StormTrooper/Commodore-Plus4/3d/pushbutton-switch.step

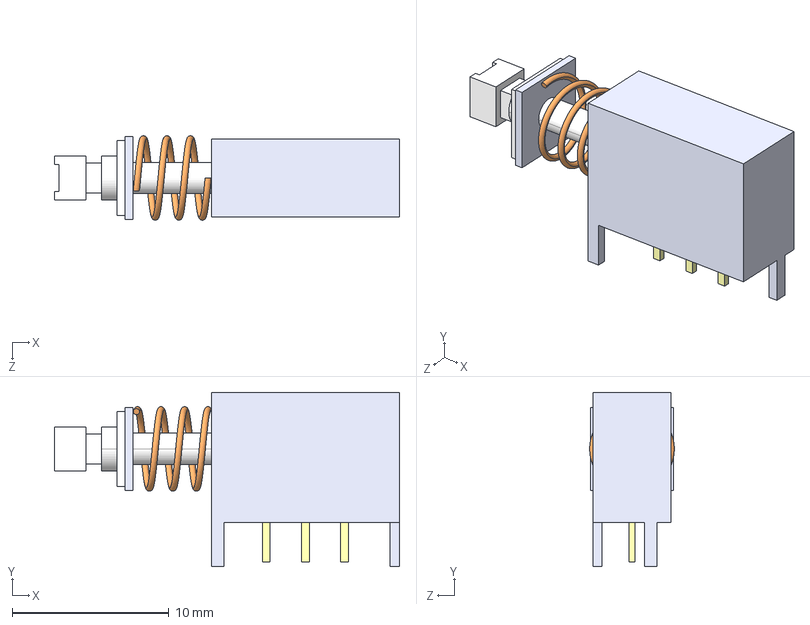
[picture p2: CAD file, 2019-05-24]
3d/pushbutton-switch.step
22.0 x 11.1 x 5.40 mm
