StormTrooper/Commodore-Plus4/3d/rectifier.step

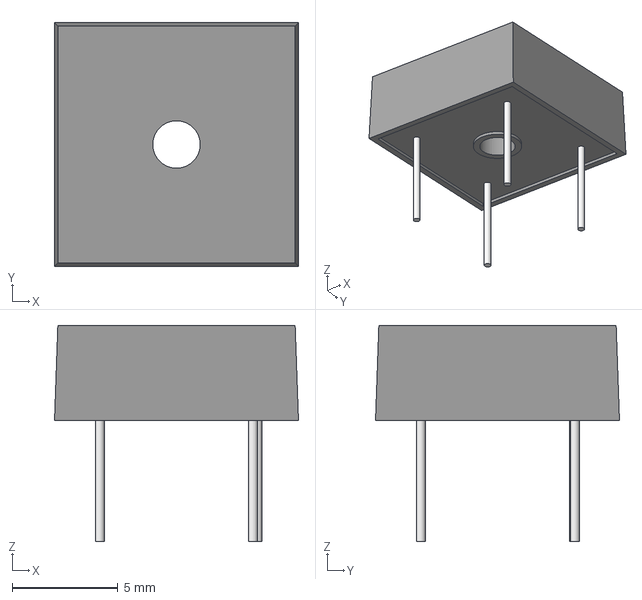
[picture p3: CAD file, 2019-05-24]
3d/rectifier.step
11.5 x 11.5 x 10.2 mm
