StormTrooper/Commodore-Plus4/Commodore Plus 4.kicad_pcb

## KiCad design Commodore Plus 4.kicad_pcb (2019-05-24)

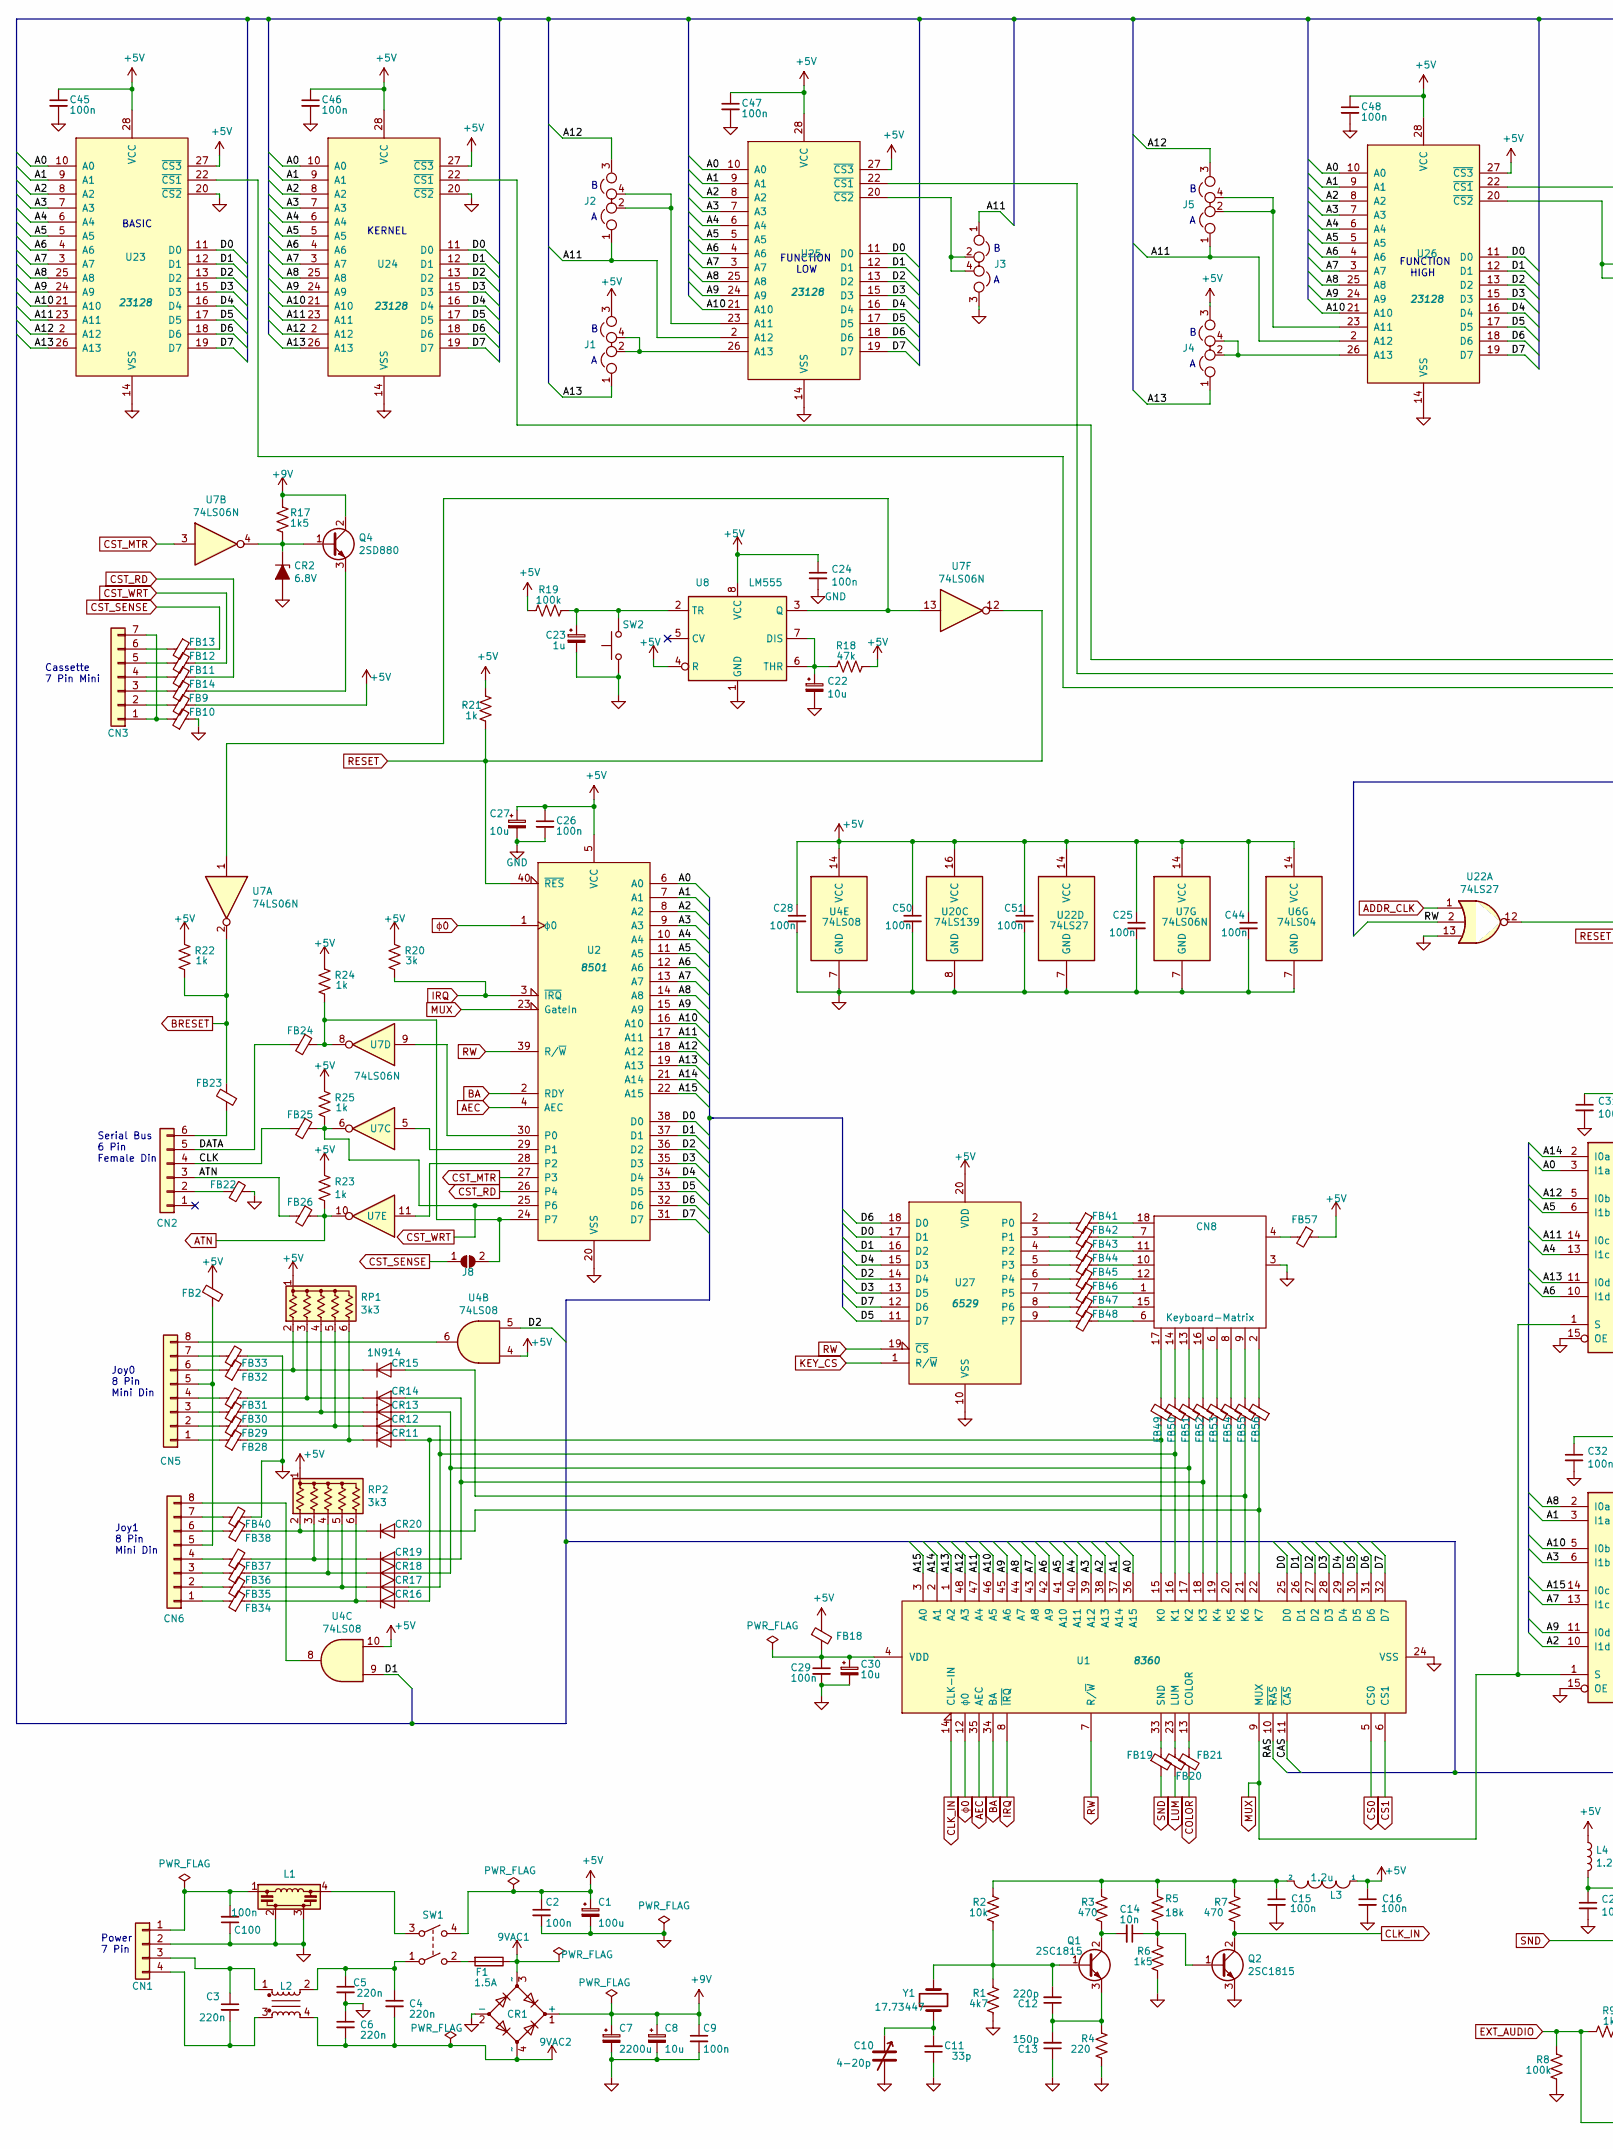
[picture p4: schematic Commodore Plus 4.sch, part in row 1, column 1]

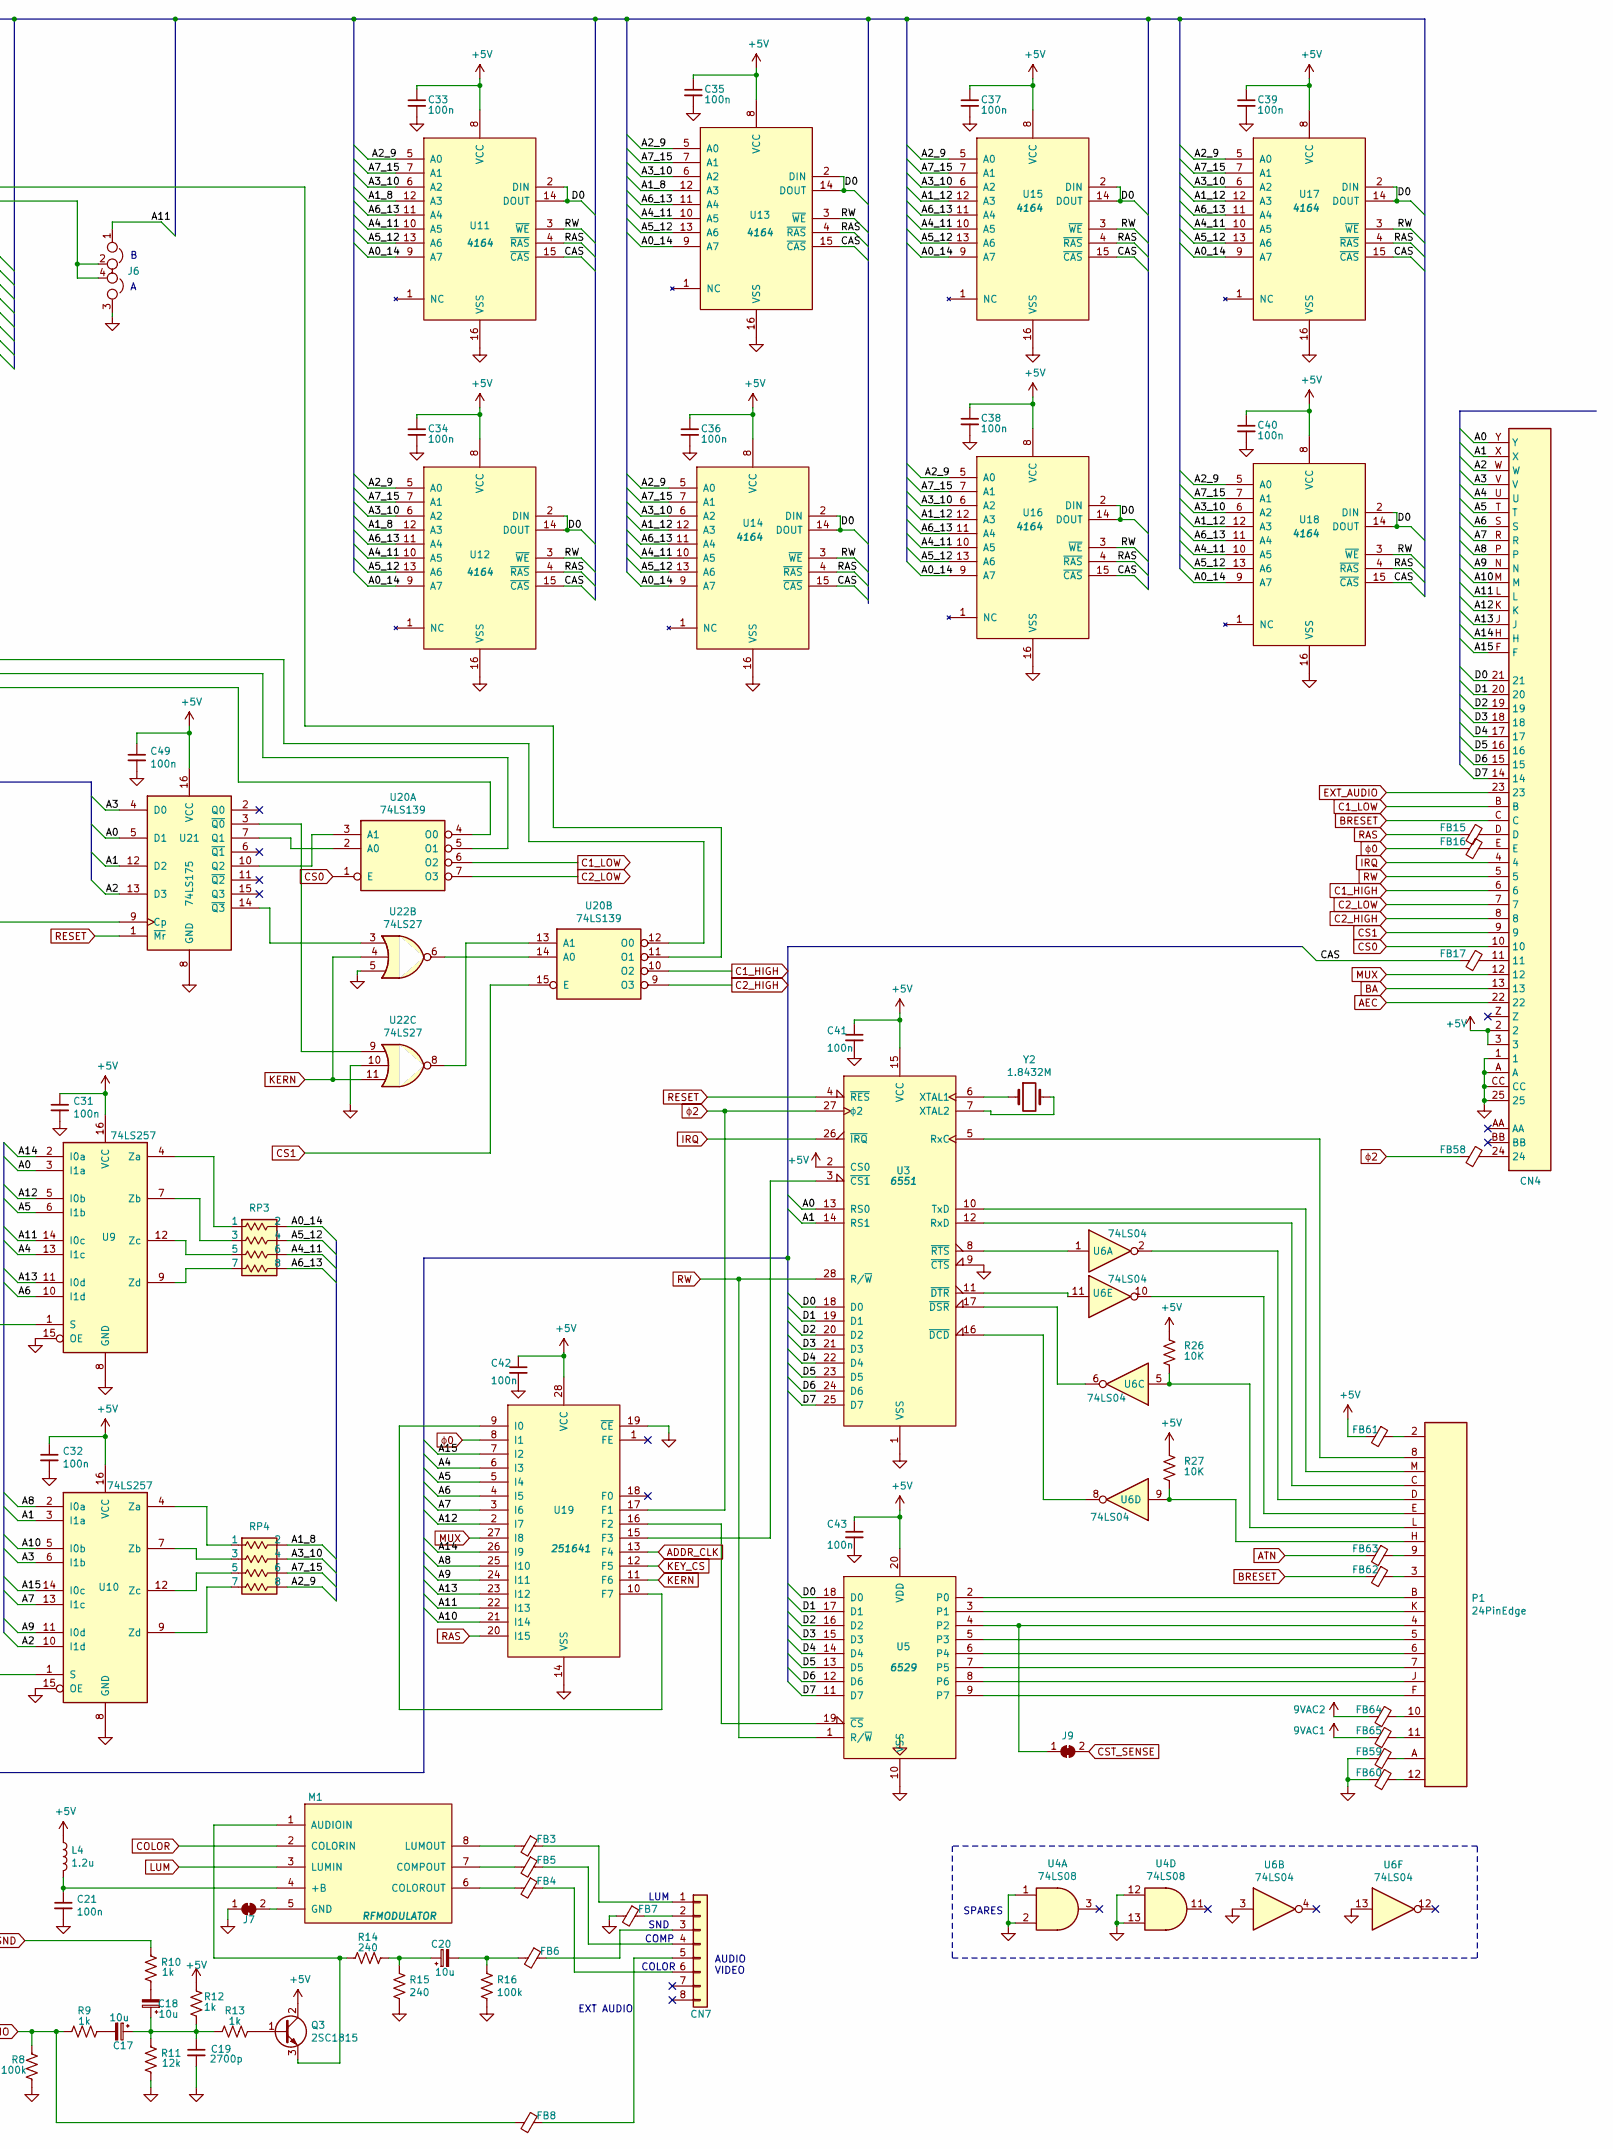
[picture p5: schematic Commodore Plus 4.sch, part in row 1, column 2]

Parts:
C1: 100u; CP_Radial_D8.0mm_P3.50mm
C2, C9, C15, C16, C21, C24, C25, C26, C28, C29, C31, C32, C33, C34, C35, C36, C37, C38, C39, C41, C42, C43, C44, C45, C46, C47, C48, C49, C50, C51: 100n; C_Disc_D5.0mm_W2.5mm_P5.00mm
C3: 220n; C_Disc_D12.5mm_W5.0mm_P10.00mm
C4: 220n; Capacitor_D12.5mm_W5.0mm_P10.00mm
C5, C6: 220n; C_Disc_D5.0mm_W2.5mm_P5.00mm
C7: 2200u; CP_Axial_L40.0mm_D16.0mm_P48.00mm_Horizontal
C8, C20, C27: 10u; CP_Radial_D6.3mm_P2.50mm
C10: 4-20p; TrimCap_251029-02
C11: 33p; C_Disc_D5.0mm_W2.5mm_P5.00mm
C12: 220p; C_Disc_D5.0mm_W2.5mm_P5.00mm
C13: 150p; C_Disc_D5.0mm_W2.5mm_P5.00mm
C14: 10n; C_Disc_D5.0mm_W2.5mm_P5.00mm
C17, C18, C22, C30: 10u; C_Disc_10mm_6mm
C19: 2700p; C_Disc_D5.0mm_W2.5mm_P5.00mm
C23: 1u; CP_Radial_D6.3mm_P2.50mm
C40: 100n; C_Rect_L7.0mm_W2.5mm_P5.00mm
C100: 100n; C_Disc_D4.7mm_W2.5mm_P5.00mm
CN1: Conn_01x04; Connector_Power_4pin_251614_01
CN2: Conn_01x07; Connector_DIN_Female_6Pin_3rows
CN3: Conn_01x07; Connector_Mini-DIN_Female_7Pin_2rows
CN4: 50PinEdge; 50Pin_Edge_Connector
CN5, CN6: Conn_01x08; Connector_Mini-DIN_Female_8Pin_2rows
CN7: Conn_01x08; Connector_DIN_Female_8Pin_3rows
CN8: Keyboard-Matrix; Keyboard_Connector
CR1: D_Bridge_+-AA; Diode_Bridge_12.5x12.5
CR2: 6.8V; D_A-405_P12.70mm_Horizontal
CR11, CR12, CR13, CR14, CR15, CR16, CR17, CR18, CR19, CR20: 1N914; D_DO-35_SOD27_P12.70mm_Horizontal
F1: 1.5A; Fuseholder_Cylinder-6.3x32mm
FB2, FB3, FB4, FB5, FB6, FB7, FB8, FB9, FB10, FB11, FB12, FB13, FB14, FB22, FB23, FB24, FB25, FB26, FB28, FB29, FB30, FB31, FB32, FB33, FB34, FB35, FB36, FB37, FB38, FB40, FB59, FB61, FB62, FB63: Ferrite_Bead_Small; L_Axial_L7.0mm_D3.3mm_P5.08mm_Vertical
FB15, FB16, FB17, FB18, FB19, FB20, FB21, FB41, FB42, FB43, FB44, FB45, FB46, FB47, FB48, FB49, FB50, FB51, FB52, FB53, FB54, FB55, FB56, FB57, FB58, FB60, FB64, FB65: Ferrite_Bead_Small; Ferrite_Bead_L5.0mm_D3.6mm_P13.00mm_Horizontal
J1, J2, J3, J4, J5, J6: Jumper_NC_Dual; Jumper
J7, J9: SolderJumper_2_Bridged; SolderJumper-2_P1.3mm_Bridged_RoundedPad1.0x1.5mm
J8: SolderJumper_2_Open; SolderJumper-2_P1.3mm_Open_RoundedPad1.0x1.5mm
L1: EMI_Filter; EMI-Filter
L2: EMI_Filter_CommonMode; Noise_Filter
L3, L4: 1.2u; L_Axial_L10.0mm_D4.0mm_P15.5mm_Horizontal
M1: RFMODULATOR; RF_Modulator
P1: 24PinEdge; 24Pin_Edge
Q1, Q2, Q3: 2SC1815; TO-92L_Inline_Wide
Q4: 2SD880; TO-220-3_Vertical
R1: 4k7; Resistor_Horizontal
R2: 10k; Resistor_Horizontal
R3, R7: 470; Resistor_Horizontal
R4: 220; Resistor_Horizontal
R5: 18k; Resistor_Horizontal
R6, R17: 1k5; Resistor_Horizontal
R8, R16, R19: 100k; Resistor_Horizontal
R9, R10, R12, R13, R21, R22, R23, R24, R25: 1k; Resistor_Horizontal
R11: 12k; Resistor_Horizontal
R14, R15: 240; Resistor_Horizontal
R18: 47k; Resistor_Horizontal
R20: 3k; Resistor_Horizontal
R26, R27: 10K; Resistor_Horizontal
RP1, RP2: 3k3; R_Array_SIP6
RP3, RP4: Resistor-Network; R_Array_SIP8
SW1: SW_DPST; Switch-Rocker
SW2: SW_Push; Switch-Pushbutton
U1: 8360; DIP-48_W15.24mm
U2: 8501; DIP-40_W15.24mm
U3: 6551; DIP-28_W15.24mm
U4: 74LS08; DIP-14_W7.62mm
U5, U27: 6529; DIP-20_W7.62mm
U6: 74LS04; DIP-14_W7.62mm
U7: 74LS06N; DIP-14_W7.62mm
U8: LM555; DIP-8_W7.62mm
U9, U10: 74LS257; DIP-16_W7.62mm
U11, U12, U13, U14, U15, U16, U17, U18: 4164; DIP-16_W7.62mm
U19: 251641; DIP-28_W15.24mm
U20: 74LS139; DIP-16_W7.62mm
U21: 74LS175; DIP-16_W7.62mm
U22: 74LS27; DIP-14_W7.62mm
U23, U24, U25, U26: 23128; DIP-28_W15.24mm
Y1: 17.73447; Crystal_HC18-U_Horizontal
Y2: 1.8432M; Crystal_HC33-U_Horizontal

Connections:
9VAC1: CR1.3 (~~), F1.1, FB65.2
9VAC2: C4.2, C6.2, CR1.4 (~~), FB64.2, L2.4
+5V: C1.1, C2.1, C16.1, C24.1, C25.1, C26.1, C27.1, C28.1, C31.1, C32.1, C33.1, C34.1, C35.1, C36.1, C37.1, C38.1, C39.1, C40.1, C41.1, C42.1, C43.1, C44.1, C45.1, C46.1, C47.1, C48.1, C49.1, C50.1, C51.1, CN4.2, CN4.3, FB2.2, FB9.1, FB18.1, FB57.1, FB61.2, J1.3, J4.3, L3.1, L4.1, Q3.2 (C), R12.1, R18.1, R19.2, R20.1, R21.2, R22.1, R23.1, R24.1, R25.1, R26.1, R27.1, RP1.1 (common), RP2.1 (common), SW1.4, U2.5 (VCC), U3.2 (CS0), U3.15 (VCC), U4.4, U4.10, U4.14 (VCC), U5.20 (VDD), U6.14 (VCC), U7.14 (VCC), U8.4 (R), U8.8 (VCC), U9.16 (VCC), U10.16 (VCC), U11.8 (VCC), U12.8 (VCC), U13.8 (VCC), U14.8 (VCC), U15.8 (VCC), U16.8 (VCC), U17.8 (VCC), U18.8 (VCC), U19.28 (VCC), U20.16 (VCC), U21.16 (VCC), U22.14 (VCC), U23.27 (~CS3), U23.28 (VCC), U24.27 (~CS3), U24.28 (VCC), U25.27 (~CS3), U25.28 (VCC), U26.27 (~CS3), U26.28 (VCC), U27.20 (VDD)
+9V: C7.1, C8.1, C9.1, CR1.1 (+), Q4.2 (C), R17.1
/A0: CN4.Y, U1.36 (A15), U2.6 (A0), U3.13 (RS0), U9.3 (I1a), U21.5 (D1), U23.10 (A0), U24.10 (A0), U25.10 (A0), U26.10 (A0)
/A0_14: RP3.2, U11.9 (A7), U12.9 (A7), U13.9 (A7), U14.9 (A7), U15.9 (A7), U16.9 (A7), U17.9 (A7), U18.9 (A7)
/A1: CN4.X, U1.37 (A14), U2.7 (A1), U3.14 (RS1), U10.3 (I1a), U21.12 (D2), U23.9 (A1), U24.9 (A1), U25.9 (A1), U26.9 (A1)
/A1_8: RP4.2, U11.12 (A3), U12.12 (A3), U13.12 (A3)
/A1_12: U14.12 (A3), U15.12 (A3), U16.12 (A3), U17.12 (A3), U18.12 (A3)
/A2: CN4.W, U1.38 (A13), U2.8 (A2), U10.10 (I1d), U21.13 (D3), U23.8 (A2), U24.8 (A2), U25.8 (A2), U26.8 (A2)
/A2_9: RP4.8, U11.5 (A0), U12.5 (A0), U13.5 (A0), U14.5 (A0), U15.5 (A0), U16.5 (A0), U17.5 (A0), U18.5 (A0)
/A3: CN4.V, U1.39 (A12), U2.9 (A3), U10.6 (I1b), U21.4 (D0), U23.7 (A3), U24.7 (A3), U25.7 (A3), U26.7 (A3)
/A3_10: RP4.4, U11.6 (A2), U12.6 (A2), U13.6 (A2), U14.6 (A2), U15.6 (A2), U16.6 (A2), U17.6 (A2), U18.6 (A2)
/A4: CN4.U, U1.40 (A11), U2.10 (A4), U9.13 (I1c), U19.6 (I3), U23.6 (A4), U24.6 (A4), U25.6 (A4), U26.6 (A4)
/A4_11: RP3.6, U11.10 (A5), U12.10 (A5), U13.10 (A5), U14.10 (A5), U15.10 (A5), U16.10 (A5), U17.10 (A5), U18.10 (A5)
/A5: CN4.T, U1.41 (A10), U2.11 (A5), U9.6 (I1b), U19.5 (I4), U23.5 (A5), U24.5 (A5), U25.5 (A5), U26.5 (A5)
/A5_12: RP3.4, U11.13 (A6), U12.13 (A6), U13.13 (A6), U14.13 (A6), U15.13 (A6), U16.13 (A6), U17.13 (A6), U18.13 (A6)
/A6: CN4.S, U1.42 (A9), U2.12 (A6), U9.10 (I1d), U19.4 (I5), U23.4 (A6), U24.4 (A6), U25.4 (A6), U26.4 (A6)
/A6_13: RP3.8, U11.11 (A4), U12.11 (A4), U13.11 (A4), U14.11 (A4), U15.11 (A4), U16.11 (A4), U17.11 (A4), U18.11 (A4)
/A7: CN4.R, U1.43 (A8), U2.13 (A7), U10.13 (I1c), U19.3 (I6), U23.3 (A7), U24.3 (A7), U25.3 (A7), U26.3 (A7)
/A7_15: RP4.6, U11.7 (A1), U12.7 (A1), U13.7 (A1), U14.7 (A1), U15.7 (A1), U16.7 (A1), U17.7 (A1), U18.7 (A1)
/A8: CN4.P, U1.44 (A7), U2.14 (A8), U10.2 (I0a), U19.25 (I10), U23.25 (A8), U24.25 (A8), U25.25 (A8), U26.25 (A8)
/A9: CN4.N, U1.45 (A6), U2.15 (A9), U10.11 (I0d), U19.24 (I11), U23.24 (A9), U24.24 (A9), U25.24 (A9), U26.24 (A9)
/A10: CN4.M, U1.46 (A5), U2.16 (A10), U10.5 (I0b), U19.21 (I14), U23.21 (A10), U24.21 (A10), U25.21 (A10), U26.21 (A10)
/A11: CN4.L, J2.1, J3.1, J5.1, J6.1, U1.47 (A4), U2.17 (A11), U9.14 (I0c), U19.22 (I13), U23.23 (A11), U24.23 (A11), U25.2 (A12), U26.2 (A12)
/A12: CN4.K, J2.3, J5.3, U1.48 (A3), U2.18 (A12), U9.5 (I0b), U19.2 (I7), U23.2 (A12), U24.2 (A12)
/A13: CN4.J, J1.1, J4.1, U1.1 (A2), U2.19 (A13), U9.11 (I0d), U19.23 (I12), U23.26 (A13), U24.26 (A13)
/A14: CN4.H, U1.2 (A1), U2.21 (A14), U9.2 (I0a), U19.26 (I9)
/A15: CN4.F, U1.3 (A0), U2.22 (A15), U10.14 (I0c), U19.7 (I2)
/CAS: FB17.2, U1.11 (~CAS), U11.15 (~CAS), U12.15 (~CAS), U13.15 (~CAS), U14.15 (~CAS), U15.15 (~CAS), U16.15 (~CAS), U17.15 (~CAS), U18.15 (~CAS)
/CLK: CN2.4, FB25.2
/D0: CN4.21, U1.25 (D0), U2.38 (D0), U3.18 (D0), U5.18 (D0), U11.2 (DIN), U11.14 (DOUT), U12.2 (DIN), U12.14 (DOUT), U13.2 (DIN), U13.14 (DOUT), U14.2 (DIN), U14.14 (DOUT), U15.2 (DIN), U15.14 (DOUT), U16.2 (DIN), U16.14 (DOUT), U17.2 (DIN), U17.14 (DOUT), U18.2 (DIN), U18.14 (DOUT), U23.11 (D0), U24.11 (D0), U25.11 (D0), U26.11 (D0), U27.17 (D1)
/D1: CN4.20, U1.26 (D1), U2.37 (D1), U3.19 (D1), U4.9, U5.17 (D1), U23.12 (D1), U24.12 (D1), U25.12 (D1), U26.12 (D1), U27.16 (D2)
/D2: CN4.19, U1.27 (D2), U2.36 (D2), U3.20 (D2), U4.5, U5.16 (D2), U23.13 (D2), U24.13 (D2), U25.13 (D2), U26.13 (D2), U27.14 (D4)
/D3: CN4.18, U1.28 (D3), U2.35 (D3), U3.21 (D3), U5.15 (D3), U23.15 (D3), U24.15 (D3), U25.15 (D3), U26.15 (D3), U27.13 (D5)
/D4: CN4.17, U1.29 (D4), U2.34 (D4), U3.22 (D4), U5.14 (D4), U23.16 (D4), U24.16 (D4), U25.16 (D4), U26.16 (D4), U27.15 (D3)
/D5: CN4.16, U1.30 (D5), U2.33 (D5), U3.23 (D5), U5.13 (D5), U23.17 (D5), U24.17 (D5), U25.17 (D5), U26.17 (D5), U27.11 (D7)
/D6: CN4.15, U1.31 (D6), U2.32 (D6), U3.24 (D6), U5.12 (D6), U23.18 (D6), U24.18 (D6), U25.18 (D6), U26.18 (D6), U27.18 (D0)
/D7: CN4.14, U1.32 (D7), U2.31 (D7), U3.25 (D7), U5.11 (D7), U23.19 (D7), U24.19 (D7), U25.19 (D7), U26.19 (D7), U27.12 (D6)
/DATA: CN2.5, FB24.2
ADDR_CLK: U19.13 (F4), U22.1
AEC: CN4.22, U1.35 (AEC), U2.4 (AEC)
ATN: CN2.3, FB26.1, FB26.2, FB63.2, R23.2, U7.10
BA: CN4.13, U1.34 (BA), U2.2 (RDY)
BRESET: CN4.C, FB23.2, FB62.2, R22.2, U7.2
C1_HIGH: CN4.6, U20.10 (O2)
C1_LOW: CN4.B, U20.6 (O2)
C2_HIGH: CN4.8, U20.9 (O3)
C2_LOW: CN4.7, U20.7 (O3)
CLK_IN: Q2.2 (C), R7.2, U1.14 (CLK-IN)
COLOR: FB21.2, M1.2 (COLORIN)
CS0: CN4.10, U1.5 (CS0), U20.1 (E)
CS1: CN4.9, U1.6 (CS1), U20.15 (E)
CST_MTR: U2.27 (P3), U7.3
CST_RD: FB11.1, U2.26 (P4)
CST_SENSE: FB13.1, J8.1 (A), J9.2 (B)
CST_WRT: FB12.1, FB25.1, R25.2, U2.25 (P6), U7.6
EXT_AUDIO: CN4.23, FB8.2, R8.1, R9.2
GND: C1.2, C2.2, C5.2, C6.1, C7.2, C8.2, C9.2, C10.2, C11.1, C13.1, C15.2, C16.2, C19.2, C21.2, C22.2, C23.2, C24.2, C25.2, C26.2, C27.2, C28.2, C29.2, C30.2, C31.2, C32.2, C33.2, C34.2, C35.2, C36.2, C37.2, C38.2, C39.2, C40.2, C41.2, C42.2, C43.2, C44.2, C45.2, C46.2, C47.2, C48.2, C49.2, C50.2, C51.2, C100.1, CN1.2, CN4.1, CN4.25, CN4.A, CN4.CC, CN8.3, CR1.2 (-), CR2.2 (A), FB7.2, FB10.2, FB22.1, FB33.2, FB40.2, FB59.2, FB60.2, J3.3, J6.3, J7.1 (A), L1.2, L1.3, Q2.3 (E), R1.2, R4.2, R6.2, R8.2, R11.2, R15.2, R16.2, SW2.1, U1.24 (VSS), U2.20 (VSS), U3.1 (VSS), U3.9 (~CTS), U4.1, U4.2, U4.7 (GND), U4.12, U4.13, U5.10 (VSS), U6.3, U6.7 (GND), U6.13, U7.7 (GND), U8.1 (GND), U9.8 (GND), U9.15 (OE), U10.8 (GND), U10.15 (OE), U11.16 (VSS), U12.16 (VSS), U13.16 (VSS), U14.16 (VSS), U15.16 (VSS), U16.16 (VSS), U17.16 (VSS), U18.16 (VSS), U19.14 (VSS), U19.19 (~CE), U20.8 (GND), U21.8 (GND), U22.5, U22.7 (GND), U22.10, U22.13, U23.14 (VSS), U23.20 (~CS2), U24.14 (VSS), U24.20 (~CS2), U25.14 (VSS), U26.14 (VSS), U27.10 (VSS)
IRQ: CN4.4, R20.2, U1.8 (~IRQ), U2.3 (~IRQ), U3.26 (~IRQ)
KERN: U19.11 (F6), U22.4, U22.11
KEY_CS: U19.12 (F5), U27.1 (R/~W)
LUM: FB20.2, M1.3 (LUMIN)
MUX: CN4.12, U1.9 (MUX), U2.23 (GateIn), U9.1 (S), U10.1 (S), U19.27 (I8)
unnamed: C3.1, CN1.3, L2.1
unnamed: C3.2, CN1.4, L2.3
unnamed: C4.1, C5.1, L2.2, SW1.1
unnamed: C10.1, C11.2, Y1.2
unnamed: C12.1, C13.2, Q1.3 (E), R4.1
unnamed: C12.2, Q1.1 (B), R1.1, R2.2, Y1.1
unnamed: C14.1, Q2.1 (B), R5.2, R6.1
unnamed: C14.2, Q1.2 (C), R3.2
unnamed: C15.1, L3.2, R2.1, R3.1, R5.1, R7.1
unnamed: C17.1, C18.1, C19.1, R11.1, R12.2, R13.2
unnamed: C17.2, R9.1
unnamed: C18.2, R10.2
unnamed: C20.1, R14.1, R15.1
unnamed: C20.2, FB6.2, R16.1
unnamed: C21.1, L4.2, M1.4 (+B)
unnamed: C22.1, R18.2, U8.6 (THR), U8.7 (DIS)
unnamed: C23.1, R19.1, SW2.2, U8.2 (TR)
unnamed: C29.1, C30.1, FB18.2, U1.4 (VDD)
unnamed: C100.2, CN1.1, L1.1
unnamed: CN2.2, FB22.2
unnamed: CN2.6, FB23.1
unnamed: CN3.1, CN3.7, FB10.1
unnamed: CN3.2, FB9.2
unnamed: CN3.3, FB14.2
unnamed: CN3.4, FB11.2
unnamed: CN3.5, FB12.2
unnamed: CN3.6, FB13.2
unnamed: CN4.11, FB17.1
unnamed: CN4.24, FB58.1
unnamed: CN4.D, FB15.1
unnamed: CN4.E, FB16.1
unnamed: CN5.1, FB28.1
unnamed: CN5.2, FB29.1
unnamed: CN5.3, FB30.1
unnamed: CN5.4, FB31.1
unnamed: CN5.5, CN6.5, FB2.1
unnamed: CN5.6, FB32.1
unnamed: CN5.7, FB33.1
unnamed: CN5.8, U4.6
unnamed: CN6.1, FB34.1
unnamed: CN6.2, FB35.1
unnamed: CN6.3, FB36.1
unnamed: CN6.4, FB37.1
unnamed: CN6.6, FB38.1
unnamed: CN6.7, FB40.1
unnamed: CN6.8, U4.8
unnamed: CN7.1, FB3.1
unnamed: CN7.2, FB7.1
unnamed: CN7.3, FB6.1
unnamed: CN7.4, FB5.1
unnamed: CN7.5, FB8.1
unnamed: CN7.6, FB4.1
unnamed: CN8.1, FB46.1
unnamed: CN8.2, FB56.2
unnamed: CN8.4, FB57.2
unnamed: CN8.7, FB42.1
unnamed: CN8.8, FB54.2
unnamed: CN8.9, FB55.2
unnamed: CN8.10, FB44.1
unnamed: CN8.11, FB43.1
unnamed: CN8.12, FB45.1
unnamed: CN8.13, FB51.2
unnamed: CN8.14, FB50.2
unnamed: CN8.15, FB47.1
unnamed: CN8.16, FB52.2
unnamed: CN8.17, FB49.2
unnamed: CN8.18, FB41.1
unnamed: CR2.1 (K), Q4.1 (B), R17.2, U7.4
unnamed: CR11.1 (K), FB28.2, RP1.6 (R5)
unnamed: CR11.2 (A), CR16.2 (A), FB49.1, U1.15 (K0)
unnamed: CR12.1 (K), FB29.2, RP1.5 (R4)
unnamed: CR12.2 (A), CR17.2 (A), FB50.1, U1.16 (K1)
unnamed: CR13.1 (K), FB30.2, RP1.4 (R3)
unnamed: CR13.2 (A), CR18.2 (A), FB51.1, U1.17 (K2)
unnamed: CR14.1 (K), FB31.2, RP1.3 (R2)
unnamed: CR14.2 (A), CR19.2 (A), FB52.1, U1.18 (K3)
unnamed: CR15.1 (K), FB32.2, RP1.2 (R1)
unnamed: CR15.2 (A), FB55.1, U1.21 (K6)
unnamed: CR16.1 (K), FB34.2, RP2.6 (R5)
unnamed: CR17.1 (K), FB35.2, RP2.5 (R4)
unnamed: CR18.1 (K), FB36.2, RP2.4 (R3)
unnamed: CR19.1 (K), FB37.2, RP2.3 (R2)
unnamed: CR20.1 (K), FB38.2, RP2.2 (R1)
unnamed: CR20.2 (A), FB56.1, U1.22 (K7)
unnamed: F1.2, SW1.2
unnamed: FB3.2, M1.8 (LUMOUT)
unnamed: FB4.2, M1.6 (COLOROUT)
unnamed: FB5.2, M1.7 (COMPOUT)
unnamed: FB14.1, Q4.3 (E)
unnamed: FB19.1, U1.33 (SND)
unnamed: FB20.1, U1.23 (LUM)
unnamed: FB21.1, U1.13 (COLOR)
unnamed: FB24.1, J8.2 (B), R24.2, U2.24 (P7), U7.8
unnamed: FB41.2, U27.2 (P0)
unnamed: FB42.2, U27.3 (P1)
unnamed: FB43.2, U27.4 (P2)
unnamed: FB44.2, U27.5 (P3)
unnamed: FB45.2, U27.6 (P4)
unnamed: FB46.2, U27.7 (P5)
unnamed: FB47.2, U27.8 (P6)
unnamed: FB48.2, U27.9 (P7)
unnamed: FB53.1, U1.19 (K4)
unnamed: FB54.1, U1.20 (K5)
unnamed: FB59.1, P1.A
unnamed: FB60.1, P1.12
unnamed: FB61.1, P1.2
unnamed: FB62.1, P1.3
unnamed: FB63.1, P1.9
unnamed: FB64.1, P1.10
unnamed: FB65.1, P1.11
unnamed: J1.2, J1.4, U25.26 (A13)
unnamed: J2.2, J2.4, U25.23 (A11)
unnamed: J3.2, J3.4, U25.20 (~CS2)
unnamed: J4.2, J4.4, U26.26 (A13)
unnamed: J5.2, J5.4, U26.23 (A11)
unnamed: J6.2, J6.4, U26.20 (~CS2)
unnamed: J7.2 (B), M1.5 (GND)
unnamed: J9.1 (A), P1.4, U5.4 (P2)
unnamed: L1.4, SW1.3
unnamed: M1.1 (AUDIOIN), Q3.3 (E), R14.2
unnamed: P1.5, U5.5 (P3)
unnamed: P1.6, U5.6 (P4)
unnamed: P1.7, U5.7 (P5)
unnamed: P1.8, U3.5 (RxC)
unnamed: P1.B, U5.2 (P0)
unnamed: P1.C, U3.12 (RxD)
unnamed: P1.D, U6.2
unnamed: P1.E, U6.10
unnamed: P1.F, U5.9 (P7)
unnamed: P1.H, R27.2, U6.9
unnamed: P1.J, U5.8 (P6)
unnamed: P1.K, U5.3 (P1)
unnamed: P1.L, R26.2, U6.5
unnamed: P1.M, U3.10 (TxD)
unnamed: Q3.1 (B), R13.1
unnamed: RP3.1, U9.4 (Za)
unnamed: RP3.3, U9.7 (Zb)
unnamed: RP3.5, U9.12 (Zc)
unnamed: RP3.7, U9.9 (Zd)
unnamed: RP4.1, U10.4 (Za)
unnamed: RP4.3, U10.7 (Zb)
unnamed: RP4.5, U10.12 (Zc)
unnamed: RP4.7, U10.9 (Zd)
unnamed: U2.28 (P2), U7.11
unnamed: U2.29 (P1), U7.5
unnamed: U2.30 (P0), U7.9
unnamed: U3.6 (XTAL1), Y2.1
unnamed: U3.7 (XTAL2), Y2.2
unnamed: U3.8 (~RTS), U6.1
unnamed: U3.11 (~DTR), U6.11
unnamed: U3.16 (~DCD), U6.8
unnamed: U3.17 (~DSR), U6.6
unnamed: U7.1, U7.13, U8.3 (Q)
unnamed: U19.9 (I0), U19.10 (F7)
unnamed: U3.3 (~CS1), U19.15 (F3)
unnamed: U5.19 (~CS), U19.16 (F2)
unnamed: U20.2 (A0), U21.7 (Q1)
unnamed: U20.3 (A1), U21.10 (Q2)
unnamed: U20.4 (O0), U23.22 (~CS1)
unnamed: U20.5 (O1), U25.22 (~CS1)
unnamed: U20.11 (O1), U26.22 (~CS1)
unnamed: U20.12 (O0), U24.22 (~CS1)
unnamed: U20.13 (A1), U22.8
unnamed: U20.14 (A0), U22.6
unnamed: U21.3 (~Q0), U22.9
unnamed: U21.9 (Cp), U22.12
unnamed: U21.14 (~Q3), U22.3
RAS: FB15.2, U1.10 (~RAS), U11.4 (~RAS), U12.4 (~RAS), U13.4 (~RAS), U14.4 (~RAS), U15.4 (~RAS), U16.4 (~RAS), U17.4 (~RAS), U18.4 (~RAS), U19.20 (I15)
RESET: R21.1, U2.40 (~RES), U3.4 (~RES), U7.12, U21.1 (~Mr)
RW: CN4.5, U1.7 (R/~W), U2.39 (R/~W), U3.28 (R/~W), U5.1 (R/~W), U11.3 (~WE), U12.3 (~WE), U13.3 (~WE), U14.3 (~WE), U15.3 (~WE), U16.3 (~WE), U17.3 (~WE), U18.3 (~WE), U22.2, U27.19 (~CS)
SND: FB19.2, R10.1
ϕ0: FB16.2, U1.12 (ϕ0), U2.1 (ϕ0), U19.8 (I1)
ϕ2: FB58.2, U3.27 (ϕ2), U19.17 (F1)

Notes on the sheet:
BASIC
KERNEL
FUNCTION LOW
FUNCTION HIGH
Power 7 Pin
Serial Bus 6 Pin Female Din
Joy0 8 Pin Mini Din
Joy1 8 Pin Mini Din
LUM
SND
COMP
EXT AUDIO
COLOR
Cassette 7 Pin Mini
AUDIO VIDEO
SPARES

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
Board: 2 copper layers, 216 parts (0 on the bottom side), 238 nets, no tracks yet.
