StormTrooper/Commodore-Plus4/(threads)

Thread 1 (2020-01-19):

No License

SukkoPera, 2020-01-19:
Hi! I am working on a similar project for the Commodore 16 and I would like to add a PCB as well. Since it uses a lot of the same components as the Plus4, I would like to use your library, am I allowed to do so?

StormTrooper, 2020-01-19:
Yes, the library is free to use.

SukkoPera, 2020-01-19:
Great! I'll work on the PCB in the future. In the meantime I have released the schematics, if you are interested: https://github.com/SukkoPera/LittleSixteen.

Thanks!

Closed 2020-01-19.
